xiaohei94/ESP32_UAV/files/UAV飞行器BOM表元件清单.xlsx

序号 | 器件型号 |  | 对应的原理图位号 | 数量 | 参考价格 | 链接 | 下单数量 | 总价格 | 数量 | 邮费 | 同款店名 | 平替网址
1 | ESP32-S3-WROOM-1（D2N8） |  | U3 | 1 | 17.5 | https://item.taobao.com/item.htm?id=660619822993&ns=1&abbucket=7 (https://item.taobao.com/item.htm?spm=a21n57.1.0.0.35ee523cOPtfgP&id=660619822993&ns=1&abbucket=7) | 2 | 41.2 | 2 | 0 | 岽恒电子科技 | ESP32-S3-WROOM-1U-N16R8/N8R8/N4R8 ESP32-S3R8无线WiFi蓝牙模组-淘宝网 (taobao.com) (https://item.taobao.com/item.htm?id=697099263920&spm=a1z0d.6639537/tb.1997196601.262.38f87484KPp9Dy)
2 | MPU6050 |  | U4 | 1 | 11.8 | https://item.taobao.com/item.htm?id=522554835655&ns=1&abbucket=7 (https://item.taobao.com/item.htm?spm=a21n57.1.0.0.4480523cz0y5wR&id=522554835655&ns=1&abbucket=7) | 4 | 18.6 | 4 | 2 | 优信德电子 | 全新原装 MPU-6050 MPU6050 六轴加速度计传感器芯片 陀螺仪QFN24-淘宝网 (taobao.com) (https://item.taobao.com/item.htm?id=754096015446&skuId=5367837422216)
4 | PS7516 |  | U1 | 1 | 0.49 | https://item.taobao.com/item.htm?id=656227190862&ns=1&abbucket=7 (https://item.taobao.com/item.htm?spm=a21n57.1.0.0.4480523cz0y5wR&id=656227190862&ns=1&abbucket=7) | 10 | 5 | 10只 | 4 | 夸克微科技 | PS7516芯片 2.5A高效同步PWM升压变换器，提供技术支持-淘宝网 (taobao.com) (https://item.taobao.com/item.htm?abbucket=7&id=656227190862&ns=1&skuId=4844402580156)
 | SPL06-001 |  | U6 | 1 | 2.9 | https://item.taobao.com/item.htm?id=712430731980&ns=1&abbucket=7 (https://item.taobao.com/item.htm?spm=a21n57.1.0.0.4480523cz0y5wR&id=712430731980&ns=1&abbucket=7) | 4 | 11 | 4 |  | 优信电子 | 【优信电子】原装正品 SPL06-001 LGA-8 数字压力传感器-淘宝网 (taobao.com) (https://item.taobao.com/item.htm?id=712430731980&spm=a1z0d.6639537/tb.1997196601.1950.38f87484Y4Kv5Z)
5 | AMS1117-3.3S SOT-89 |  | U2 | 1 | 0.2 | https://item.taobao.com/item.htm?spm=a1z10.3-c-s.w4002-24706531953.9.c7776a4bVTmdOi&id=654006161406 | 10 | 1.8 | 10只 |  | 优信电子 | 原装正品 UMW AMS1117-3.3S SOT-89 1A低压差线性稳压器LDO芯片-淘宝网 (taobao.com) (https://item.taobao.com/item.htm?id=654006161406&spm=a1z0d.6639537/tb.1997196601.319.38f87484Y4Kv5Z)
6 | SI2302 |  | Q1,Q2,Q3,Q4 | 4 | 1 | https://item.taobao.com/item.htm?spm=a1z10.3-c-s.w4002-24706531953.9.12546a4b4aGwTz&id=522573849435 | 2件 | 1.8 | 20只 |  | 优信电子 | 贴片 SI2302DS SI2302 SOT-23 2A MOSFET/场效应管 （10只）-淘宝网 (taobao.com) (https://item.taobao.com/item.htm?id=522573849435&spm=a1z0d.6639537/tb.1997196601.311.38f87484Y4Kv5Z)
7 | 2PIN-1.25MM直插 |  | M1,M2,M3,M4 | 4 | 0.3 | https://detail.tmall.com/item.htm?abbucket=7&id=672236511565&ns=1&skuId=5009346547857 | 3件 | 0.9 | 30只 |  | 优信电子 | 直针 1.25mm间距 连接器 接插件2P3P4P5P6P7P8P9P10P---11P(10只)-淘宝网 (taobao.com) (https://item.taobao.com/item.htm?id=528813512664&skuId=3148215795013)
8 | 4PIN-1.25MM立贴 |  | CN1 | 1 | 1.9 | https://item.taobao.com/item.htm?spm=a1z10.3-c-s.w4002-24706531953.22.77656a4bJZnDKL&id=528813512664 | 1件 | 1.9 | 10只 |  | 优信电子 | 立贴 1.25mm间距 连接器 接插件 贴片2P3P4P5P6P7P8P---12P(10只)-淘宝网 (taobao.com) (https://item.taobao.com/item.htm?id=528734911747&skuId=4981522281627)
9 |  | 100K-R0603 | R7,R8 | 2 | 0.8 | https://item.taobao.com/item.htm?spm=a1z09.2.0.0.441b2e8dj39OHZ&id=528734911747&_u=83ko9ro6c7ab | 1 | 0.8 | 50只 |  | 优信电子 | 原装正品 0603贴片电阻 100KΩ 100千欧 1/10W 精度±1% （50只）-淘宝网 (taobao.com) (https://item.taobao.com/item.htm?id=525898432256&spm=a1z10.3-c-s.w4002-24706531953.13.44f36a4bvdCswv)
10 | 43K-R0603 |  | R1 | 1 | 1.5 | https://item.taobao.com/item.htm?spm=a1z10.3-c-s.w4002-24706531953.9.68f86a4bRWbeMg&id=522572886717 | 1 | 1.5 | 200只 |  | 优信电子 | 原装正品 0603贴片电阻 43K 标字433 1/10W 精度5% （200只）-淘宝网 (taobao.com) (https://item.taobao.com/item.htm?id=522572886717&spm=a1z0d.6639537/tb.1997196601.231.38f874846fEIW3)
11 | 10K-R0603 |  | R3,4,5,6,11,15,16,17,18,20 | 10 | 0.8 | https://item.taobao.com/item.htm?spm=a1z10.3-c-s.w4002-24706531953.44.37496a4bi12bOa&id=522577284045 | 2 | 1.6 | 100只 |  | 优信电子 | 原装正品 0603贴片电阻 10KΩ 10千欧 1/10W 精度±1% （50只）-淘宝网 (taobao.com) (https://item.taobao.com/item.htm?id=525777943950&spm=a1z0d.6639537/tb.1997196601.1694.38f87484Y4Kv5Z)
12 | 8.2K-R0603 |  | R2 | 1 | 1.5 | https://item.taobao.com/item.htm?spm=a1z10.3-c-s.w4002-24706531953.12.19b16a4bfNeZ79&id=522573289431 | 1 | 0.8 | 50只 |  | 优信电子 | 原装正品 0603贴片电阻 8.2KΩ 8.2千欧 1/10W 精度±1% （50只）-淘宝网 (taobao.com) (https://item.taobao.com/item.htm?id=525820189786&spm=a1z0d.6639537/tb.1997196601.1678.38f87484Y4Kv5Z)
13 | 4.7K-R0603 |  | R9,R10 | 2 | 0.8 | https://item.taobao.com/item.htm?id=522554307314&unid=123&relationId=2909275711&ak=26017758 | 1 | 0.8 | 50只 |  | 优信电子 | 原装正品 0603贴片电阻 4.7KΩ 4.7千欧 1/10W 精度±1% （50只）-淘宝网 (taobao.com) (https://item.taobao.com/item.htm?id=525820369368&spm=a1z0d.6639537/tb.1997196601.1670.38f87484Y4Kv5Z)
14 | 100R-R0603 |  | R12,R13,R14,R16 | 4 | 0.8 | https://item.taobao.com/item.htm?spm=a1z10.3-c-s.w4002-24706531953.9.5bd26a4baksNln&id=525741229141 | 1 | 0.8 | 50只 |  | 优信电子 | 原装正品 0603贴片电阻 100R 100欧 1/10W 精度±1% （50只）-淘宝网 (taobao.com) (https://item.taobao.com/item.htm?id=525741229141&spm=a1z0d.6639537/tb.1997196601.1662.38f87484Y4Kv5Z)
15 | 100UF-3216A |  | C9,C10 | 2 | 2.22 | https://item.taobao.com/item.htm?id=536808198807&unid=123&relationId=2909275711&ak=26017758 | 16 | 11.16 | 16只 |  | 优信电子 | 原装正品贴片钽电容3216A 6.3V 100UF 20% TLJA107M006R0800 1206-淘宝网 (taobao.com) (https://item.taobao.com/item.htm?id=536808198807)
16 | 22UF-C0603 |  | C5 | 1 | 4 | https://item.taobao.com/item.htm?spm=a1z10.3-c-s.w4002-24706531953.24.35e96a4bFxS1uE&id=522572846897 | 1 | 4 | 200只 |  | 优信电子 | 【优信电子】0603贴片电容 226M 22UF 精度±20% 6.3V（200只）-淘宝网 (taobao.com) (https://item.taobao.com/item.htm?id=522572846897&spm=a1z10.3-c-s.w4002-24706531953.24.35e96a4bFxS1uE)
17 | 10UF-3216A |  | C8,C6 | 2 | 0.96 | https://item.taobao.com/item.htm?spm=a1z10.3-c-s.w4002-24706531953.38.2c886a4bVYMy3G&id=536882424898 | 16 | 6.6 | 16只 |  | 优信电子 | 原装正品 贴片钽电容 3216A 16V 10UF ±20% TAJA106M016RNJ 1206-淘宝网 (taobao.com) (https://item.taobao.com/item.htm?id=536882424898&spm=a1z10.3-c-s.w4002-24706531953.38.2c886a4bVYMy3G)
18 | 10UF-C0603 |  | C1,C2 | 2 | 2 | https://item.taobao.com/item.htm?spm=a1z10.3-c-s.w4002-24706531953.18.24396a4bTvWSVn&id=522573110515 | 1 | 4 | 200只 |  | 优信电子 | 【优信电子】0603贴片电容 106K（10UF) 10V 精度±10% (200只）-淘宝网 (taobao.com) (https://item.taobao.com/item.htm?id=522573110515&spm=a1z10.3-c-s.w4002-24706531953.18.24396a4bTvWSVn)
19 | 4.7UF-C0603 |  | C16,C17,C18,C19 | 4 | 3 | https://item.taobao.com/item.htm?spm=a1z10.3-c-s.w4002-24706531953.18.68666a4b6frQ1v&id=522573058589 | 1 | 3 | 200只 |  | 优信电子 | 【优信电子】0603贴片电容 4.7UF (475M) 精度±20% 10V（200只）-淘宝网 (taobao.com) (https://item.taobao.com/item.htm?id=522573058589&spm=a1z10.3-c-s.w4002-24706531953.18.68666a4b6frQ1v)
20 | 1UF-C0603 |  | C13 | 1 | 2.5 | https://item.taobao.com/item.htm?spm=a1z10.3-c-s.w4002-24706531953.32.12756a4bQB8t4x&id=522577340017 | 1 | 2.5 | 200只 |  | 优信电子 | 【优信电子】0603贴片电容 105M（1UF) 16V 精度±20% (200只）-淘宝网 (taobao.com) (https://item.taobao.com/item.htm?id=522577340017&spm=a1z10.3-c-s.w4002-24706531953.32.12756a4bQB8t4x)
21 | 10NF-C0603 |  | C24 | 1 | 1.5 | https://item.taobao.com/item.htm?spm=a1z10.3-c-s.w4002-24706531953.30.12a16a4bk3upMv&id=522577056534 | 1 | 2 | 200只 |  | 优信电子 | 【优信电子】0603贴片电容 103 10NF 50V 精度±10%（200只）-淘宝网 (taobao.com) (https://item.taobao.com/item.htm?id=522577056534&spm=a1z0d.6639537/tb.1997196601.12.38f87484bZBtXC)
22 | 2.2NF-C0603 |  | C15 | 1 | 1.5 | https://item.taobao.com/item.htm?spm=a1z10.3-c-s.w4002-24706531953.20.fcd26a4bBehssS&id=522577348004 | 1 | 2 | 200只 |  | 优信电子 | 【优信电子】0603贴片电容2200PF 2.2NF 50V 精度±10% （200只）-淘宝网 (taobao.com) (https://item.taobao.com/item.htm?id=522577348004&spm=a1z0d.6639537/tb.1997196601.4.38f87484bZBtXC)
23 | 0.1UF(100NF)-C0603 |  | R3,4,7,11,12,14,22,23,25 | 9 | 2 | https://item.taobao.com/item.htm?spm=a1z10.3-c-s.w4002-24706531953.13.58546a4bKQnxs1&id=522573286298 | 1 | 2 | 200只 |  | 优信电子 | 0603贴片电容 104P 50V（0.1UF) 100NF 精度±10%（200只）-淘宝网 (taobao.com) (https://item.taobao.com/item.htm?id=522573286298&spm=a1z10.3-c-s.w4002-24706531953.13.58546a4bKQnxs1)
24 | 10UH-CD54 |  | L1 | 1 | 0.1 | https://item.taobao.com/item.htm?id=522572462024&unid=123&relationId=2909275711&ak=26017758 | 10 | 1.16 | 10只 |  | 优信电子 | CD54贴片电感 2.2 4.7 10 22 33 47 100 220 470UH 绕线功率电感-淘宝网 (taobao.com) (https://item.taobao.com/item.htm?id=522572462024&skuId=4386548117136)
25 | 3*4 龟仔/微动/轻触开关 |  | SW1,SW2 | 2 | 0.9 | https://item.taobao.com/item.htm?spm=a1z10.3-c-s.w4002-24706531953.9.54246a4bY0y2Jp&id=546724645617 | 2件 | 2.1 | 20只 |  | 优信电子 | 3*4 龟仔/微动/轻触开关/MP3/MP4/手机按键开关（10只）-淘宝网 (taobao.com) (https://item.taobao.com/item.htm?id=546724645617&skuId=3950794532932)
26 | 0603贴片LED 高亮蓝色 |  | LED1 | 1 | 0.6 | https://item.taobao.com/item.htm?spm=a1z10.3-c-s.w4002-24706531953.9.2c716a4bvNksWJ&id=522573257623 | 1 | 0.6 | 20只 |  | 优信电子 | 原装正品 0603贴片LED灯 高亮蓝色 蓝光发光二极管 （20只）-淘宝网 (taobao.com) (https://item.taobao.com/item.htm?id=522573257623&spm=a1z10.3-c-s.w4002-24706531953.9.2c716a4bvNksWJ)
27 | 0603贴片LED 高亮红色 |  | LED2 | 1 | 0.5 | https://item.taobao.com/item.htm?spm=a1z10.3-c-s.w4002-24706531953.9.2f746a4bwmja3r&id=522554271548 | 1 | 0.5 | 20只 |  | 优信电子 | 原装正品 0603贴片LED灯 高亮红色 红光发光二极管 （20只）-淘宝网 (taobao.com) (https://item.taobao.com/item.htm?id=522554271548&spm=a1z10.3-c-s.w4002-24706531953.9.2f746a4bwmja3r)
28 | 0603贴片LED 高亮黄色 |  | LED3 | 1 | 0.9 | https://item.taobao.com/item.htm?spm=a1z10.3-c-s.w4002-24706531953.11.2f746a4bwmja3r&id=522573101897 | 1 | 0.9 | 20只 |  | 优信电子 | 原装正品 0603贴片LED 高亮黄色 黄光发光二极管 （20只）-淘宝网 (taobao.com) (https://item.taobao.com/item.htm?id=522573101897&spm=a1z10.3-c-s.w4002-24706531953.11.2f746a4bwmja3r)
29 | 0603贴片LED 高亮翠绿色 |  | LED4 | 1 | 0.8 | https://item.taobao.com/item.htm?spm=a1z10.3-c-s.w4002-24706531953.15.2f746a4bwmja3r&id=522573309525 | 1 | 0.8 | 20只 |  | 优信电子 | 原装正品 0603贴片LED灯 高亮翠绿色 翠绿光发光二极管（20只）-淘宝网 (taobao.com) (https://item.taobao.com/item.htm?id=522573309525&spm=a1z10.3-c-s.w4002-24706531953.15.2f746a4bwmja3r)
30 | USB转TTL CH340模块 |  | 用于下载程序 | 1 | 4.5 | https://item.taobao.com/item.htm?id=522571378803&unid=123&relationId=2909275711&ak=26017758 | 1 | 4.5 | 1只 |  | 优信电子 | 【优信电子】USB转TTL CH340模块STC单片机下载线刷机板USB转串口-淘宝网 (taobao.com) (https://item.taobao.com/item.htm?id=522571378803&spm=a1z0d.6639537/tb.1997196601.243.38f87484SPLlhF)
31 | 1.25mm 4P 单头电子线 端子线 |  | 将CN1与串口模块连接 | 1 | 1.6 | https://item.taobao.com/item.htm?spm=a1z10.3-c-s.w4002-24706531953.9.44d96a4baZMW1o&id=565486361121 | 1 | 1.6 | 5条 |  | 优信电子 | 1.25mm 2/3/4/5/6/7/8/9/10P 单头电子线 端子线 长10CM连接线-淘宝网 (taobao.com) (https://item.taobao.com/item.htm?id=565486361121&skuId=4872047425532)
32 | 8520机架 |  |  | 1 | 9..9 | https://item.taobao.com/item.htm?id=631040798529&ns=1&abbucket=7 (https://item.taobao.com/item.htm?spm=a21n57.1.0.0.35ee523cOPtfgP&id=631040798529&ns=1&abbucket=7) | 1 | 12.9 | 1架 | 6 | 亲民模型航模 | 遥控多旋翼四轴有刷空心杯8520电机室内穿越机空心杯机架DIY套装-淘宝网 (taobao.com) (https://item.taobao.com/item.htm?abbucket=7&id=631040798529&ns=1&skuId=5125873873182)
33 | 8520空心杯电机 |  | 3.7v轴径1.2 | 4 | 25 | https://item.taobao.com/item.htm?id=631040798529&ns=1&abbucket=7 (https://item.taobao.com/item.htm?spm=a21n57.1.0.0.35ee523cOPtfgP&id=631040798529&ns=1&abbucket=7) | 1 | 28 | 4个 |  | 亲民模型航模 | 遥控多旋翼四轴有刷空心杯8520电机室内穿越机空心杯机架DIY套装-淘宝网 (taobao.com) (https://item.taobao.com/item.htm?abbucket=7&id=631040798529&ns=1&skuId=4494162609601)
34 | 螺旋桨4片2正2反 |  | 直径40mm内径1.2 | 4 | 5 | https://item.taobao.com/item.htm?id=631040798529&ns=1&abbucket=7 (https://item.taobao.com/item.htm?spm=a21n57.1.0.0.35ee523cOPtfgP&id=631040798529&ns=1&abbucket=7) | 1 | 5 | 4个 |  | 亲民模型航模 | 遥控多旋翼四轴有刷空心杯8520电机室内穿越机空心杯机架DIY套装-淘宝网 (taobao.com) (https://item.taobao.com/item.htm?abbucket=7&id=631040798529&ns=1&skuId=4979142828797)
35 | 1s动力电池 |  | 500mha，25c | 自定义 | 18 | https://item.taobao.com/item.htm?id=631040798529&ns=1&abbucket=7 (https://item.taobao.com/item.htm?spm=a21n57.1.0.0.35ee523cOPtfgP&id=631040798529&ns=1&abbucket=7) | 1 | 18 | 1只 |  | 亲民模型航模 | 遥控多旋翼四轴有刷空心杯8520电机室内穿越机空心杯机架DIY套装-淘宝网 (taobao.com) (https://item.taobao.com/item.htm?abbucket=7&id=631040798529&ns=1&skuId=4494162609598)
36 | 充电器 |  | 已有，不用买 |  | 5 | https://item.taobao.com/item.htm?id=608597899188&ns=1&abbucket=7 (https://item.taobao.com/item.htm?spm=a21n57.1.0.0.35ee523cOPtfgP&id=608597899188&ns=1&abbucket=7) | 1 | 15 | 1只 | 包邮 | 新牧之航模 | 航模1S 3.7V无人机机锂电池 空对空 JST 2.0 充电器 多充 平衡充-淘宝网 (taobao.com) (https://item.taobao.com/item.htm?abbucket=7&id=608597899188&ns=1&skuId=4439256310871)
 |  |  |  |  | 124.87 | 总价
参考价格与链接价格可能有所波动以链接价格为准
