xiaohei94/ESP32_UAV/RC_code/components/RC_control_signal/include/RC_control_signal.h

/*
 * ADC_control_signal.h
 *
 *  Created on: 2023年2月16日
 *      Author: liguanxi
 */

#ifndef COMPONENTS_RC_CONTROL_SIGNAL_INCLUDE_RC_CONTROL_SIGNAL_H_
#define COMPONENTS_RC_CONTROL_SIGNAL_INCLUDE_RC_CONTROL_SIGNAL_H_



void control_signal_init(void);

#endif /* COMPONENTS_RC_CONTROL_SIGNAL_INCLUDE_RC_CONTROL_SIGNAL_H_ */
