xiaohei94/ESP32_UAV/RC_code/components/inside_communication/UART/UART.c

/*
 * UART1.c
 *  串口通信程序
 *  Created on: 2022年11月14日
 *      Author: admin
 */

#include "UART.h"

void uart1_init(int baud) {              			//串口初始化

    const uart_config_t uart_config = {   			//串口参数结构体
        .baud_rate = baud,               			//波特率
        .data_bits = UART_DATA_8_BITS,	 			//数据位设置为8位
        .parity = UART_PARITY_DISABLE,				//禁用奇偶校验
        .stop_bits = UART_STOP_BITS_1,				//停止位设置为1位
        .flow_ctrl = UART_HW_FLOWCTRL_DISABLE,		//流量控制模式禁用（CTS/RTS）
        .source_clk = UART_SCLK_APB,				//设置时钟源
    };

    uart_driver_install(							//安装串口驱动
    					UART1_NUM,					//串口号
						RX_BUF_SIZE * 2,		 	//接收缓冲区
						0,      					//发送缓冲区
						0,       					//串口事件队列大小
						NULL,   					//串口句柄
						0      					  	//用于分配中断的标志
						);

    uart_param_config(         						//配置参数
    				  UART1_NUM,					//串口号
					  &uart_config					//串口参数结构体传入
					  );

    uart_set_pin(         							//设置引脚
    			 UART1_NUM,      					//串口号
    			 TXD_PIN, 							//发送引脚
				 RXD_PIN, 							//接收引脚
				 UART_PIN_NO_CHANGE,				//CTS
				 UART_PIN_NO_CHANGE 				//RTS
				 );

}

int sendData( const char* data)
{
    const int len = strlen(data);
    const int txBytes = uart_write_bytes(UART1_NUM, data, len);
    //ESP_LOGI(logName, "Wrote %d bytes", txBytes);
    return txBytes;
}

void tx_task(void *arg)//发送任务
{

    //static const char *TX_TASK_TAG = "TX_TASK";
    //esp_log_level_set(TX_TASK_TAG, ESP_LOG_INFO);
    while (1) {
        sendData("设置");
        sendData("\n");
        vTaskDelay(2000 / portTICK_PERIOD_MS);
    }
}

void rx_task(void *arg)//接收任务
{
    static const char *RX_TASK_TAG = "RX_TASK";
    esp_log_level_set(RX_TASK_TAG, ESP_LOG_INFO);
    uint8_t* data = (uint8_t*) malloc(RX_BUF_SIZE+1);
    while (1) {
        const int rxBytes = uart_read_bytes(UART1_NUM, data, RX_BUF_SIZE, 1000 / portTICK_RATE_MS);
        if (rxBytes > 0) {
        	uart_write_bytes(UART1_NUM, data, rxBytes);
            data[rxBytes] = 0;
            //sendData(data);
            //ESP_LOGI(RX_TASK_TAG, "Read %d bytes: '%s'", rxBytes, data);
            //ESP_LOG_BUFFER_HEXDUMP(RX_TASK_TAG, data, rxBytes, ESP_LOG_INFO);
        }
    }
    free(data);
}
