xiaohei94/ESP32_UAV/RC_code/components/VBAT/include/VBAT.h

/*
 * VBAT.h
 *
 *  Created on: 2023年2月16日
 *      Author: liguanxi
 */

#ifndef COMPONENTS_VBAT_INCLUDE_VBAT_H_
#define COMPONENTS_VBAT_INCLUDE_VBAT_H_



void VBAT_init(void);

#endif /* COMPONENTS_VBAT_INCLUDE_VBAT_H_ */
