xiaohei94/ESP32_UAV/RC_code/components/lvgl_task_v8.3/include/lv_task.h

#ifndef LV_TASK_H
#define LV_TASK_H

#ifdef __cplusplus
extern "C" {
#endif

/*********************
 *      INCLUDES
 *********************/
#include "freertos/FreeRTOS.h"
#include "freertos/task.h"
/*********************
 *      DEFINES
 *********************/

/**********************
 *      TYPEDEFS
 **********************/

/**********************
 * GLOBAL PROTOTYPES
 **********************/
void lv_task(void *arg);
void LVGL_ALL_driver_init(void);
/**********************
 *      MACROS
 **********************/

#ifdef __cplusplus
} /*extern "C"*/
#endif

#endif /*LV_TASK_H*/
