xiaohei94/ESP32_UAV/UAV_code/components/External_communication/SI24R1/include/SI24R1.h

/*
 * SI24R1.h
 *
 *  Created on: 2023年2月6日
 *      Author: liguanxi
 */

#ifndef COMPONENTS_EXTERNAL_COMMUNICATION_SI24R1_INCLUDE_SI24R1_H_
#define COMPONENTS_EXTERNAL_COMMUNICATION_SI24R1_INCLUDE_SI24R1_H_

#include <stdio.h>
#include <stdbool.h>
#include <unistd.h>




void si24r1_init(void);

#endif /* COMPONENTS_EXTERNAL_COMMUNICATION_SI24R1_INCLUDE_SI24R1_H_ */
