xiaohei94/ESP32_UAV/UAV_code/components/External_communication/anotc_client_v4.34/include/anotc.h

/*
 * anotc.h
 *  匿名上位机通信（版本v4.34）
 *  Created on: 2023年1月8日
 *      Author: liguanxi
 */

#ifndef ANOTC_H_
#define ANOTC_H_

#include <stdio.h>

void anotc_Init(void);
void anotc_data_decode (char *data);
void ANO_DT_Send_USER_DATA(char command, uint16_t data);

#endif /* COMPONENTS_ANOTC_CLIENT_V4_34_INCLUDE_ANOTC_H_ */
