xiaohei94/ESP32_UAV/UAV_code/components/sensor/GL9306/include/GL9306.h

/*
 * HMC5883L.h
 *
 *  Created on: 2023年1月8日
 *      Author: liguanxi
 */

#ifndef GL9306_H_
#define GL9306_H_

#include "IIC.h"

#include <stdio.h>
#include <stdbool.h>
#include <unistd.h>
#include "Data_declaration.h"

void GL9306_init(void);


#endif /* COMPONENTS_SENSOR_HMC5883L_HMC5883L_H_ */
