xiaohei94/ESP32_UAV/(commit log)

2026-03-14 ESP32 UAV
    [partitions.csv]
2026-03-16 add pcb
    [UAV飞行器BOM表元件清单.xlsx, 遥控器BOM表元件清单.xlsx]
2026-03-16 add pcb new
2026-03-16 add pcb new again
